yomogi517/Nucleo-F446RE_footer_ver1.0/README.md

## 使用時の注意
BNO055のフットプリントが電源とI2Cのピン側はあっていますが、INT,RESET,Voutなどのピン配が異なります。

基板外側のピンソケットのみ接続してください。
