yomogi517/Nucleo-F446RE_footer_ver1.0/回路図PDF.pdf

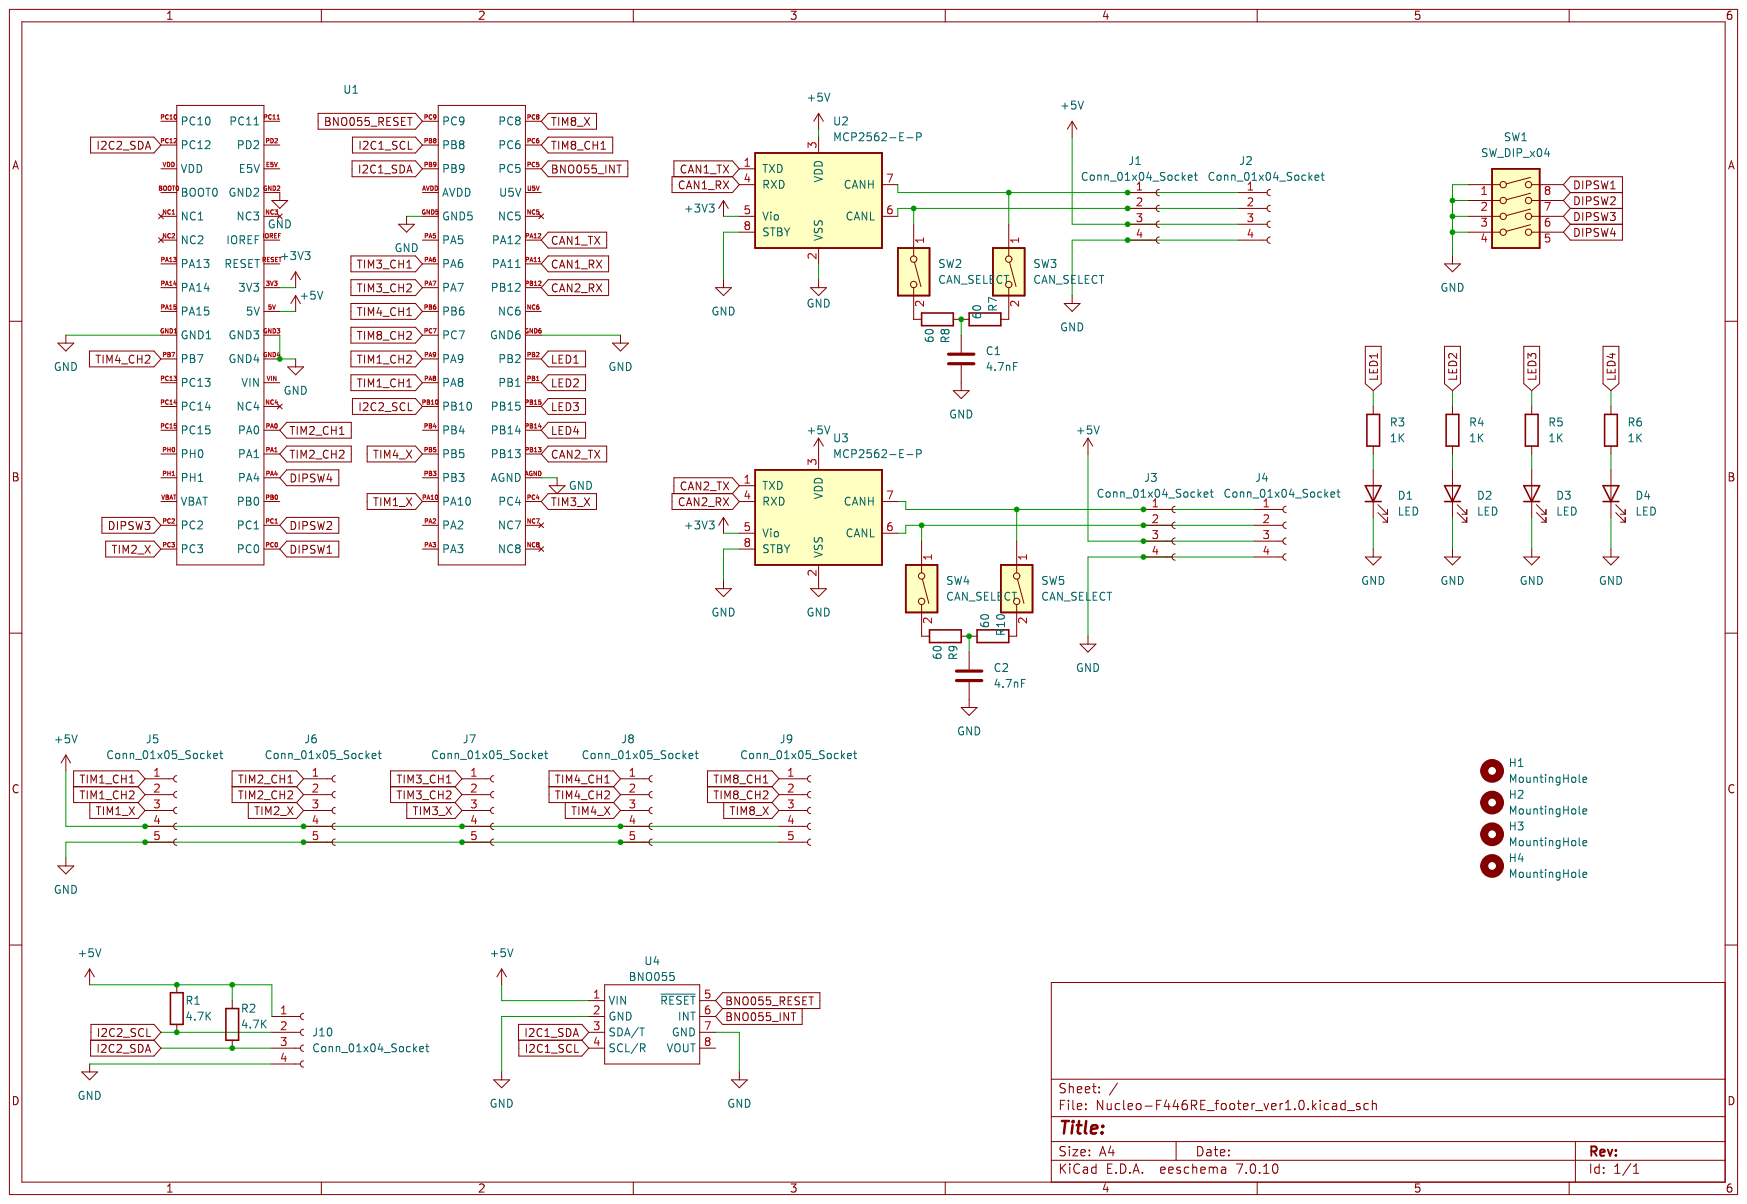
[picture p1: page 1]
