yomogi517/Nucleo-F446RE_footer_ver1.0/Nucleo-F446RE_footer_ver1.0.kicad_pcb

## KiCad design Nucleo-F446RE_footer_ver1.0.kicad_pcb (2024-04-28)

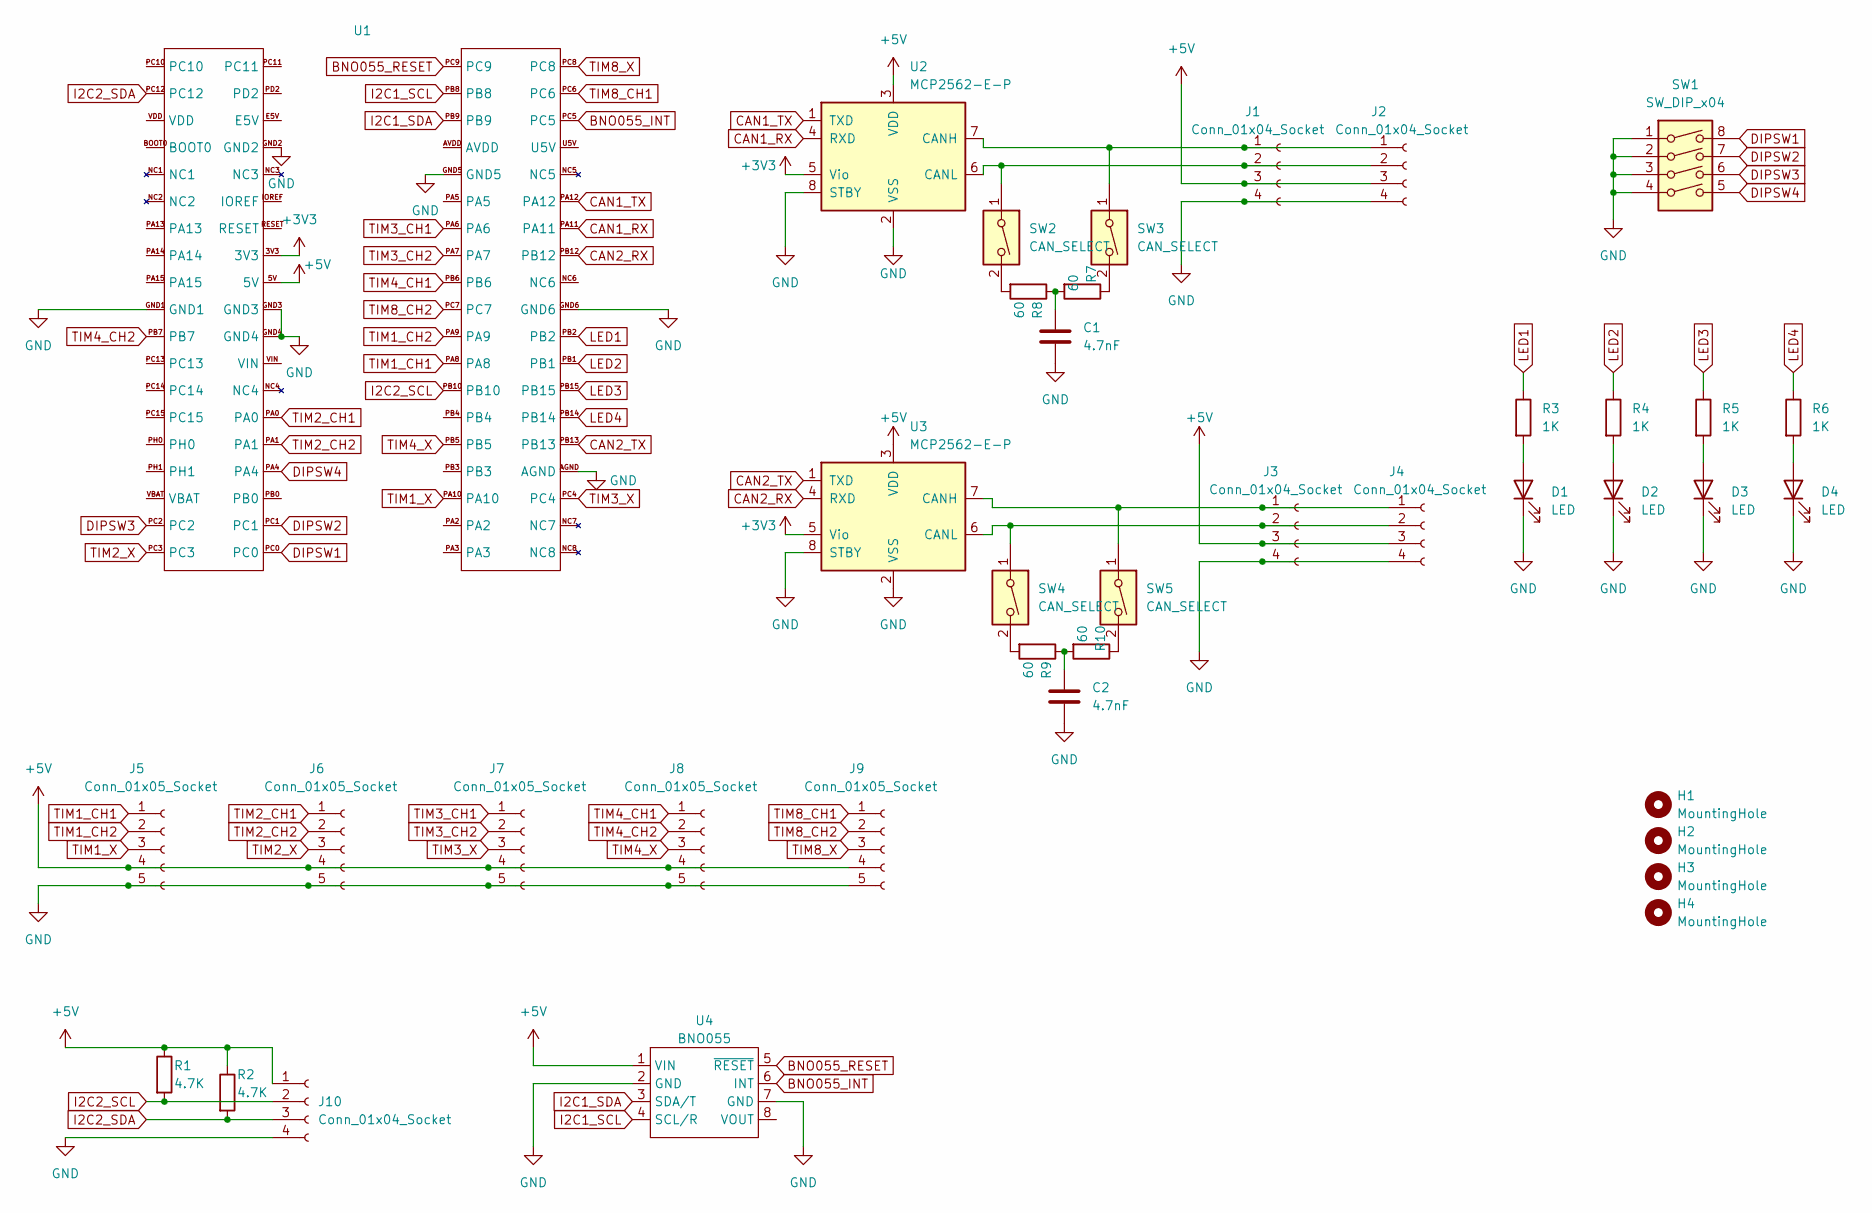
[picture p2: schematic Nucleo-F446RE_footer_ver1.0.kicad_sch]

Parts:
C1, C2: 4.7nF; C_Disc_D4.3mm_W1.9mm_P5.00mm
D1, D2, D3, D4: LED; LED_D3.0mm
H1, H2, H3, H4: MountingHole; MountingHole_3.2mm_M3
J1, J2, J3, J4: Conn_01x04_Socket; JST_XA_S04B-XASK-1_1x04_P2.50mm_Horizontal
J5, J6, J7, J8, J9: Conn_01x05_Socket; JST_XA_B05B-XASK-1_1x05_P2.50mm_Vertical
J10: Conn_01x04_Socket; JST_XA_B04B-XASK-1_1x04_P2.50mm_Vertical
R1, R2: 4.7K; R_Axial_DIN0207_L6.3mm_D2.5mm_P7.62mm_Horizontal
R3, R4, R5, R6: 1K; R_Axial_DIN0207_L6.3mm_D2.5mm_P7.62mm_Horizontal
R7, R8, R9, R10: 60; R_Axial_DIN0204_L3.6mm_D1.6mm_P7.62mm_Horizontal
SW1: SW_DIP_x04; DIP-8_W7.62mm
SW2, SW3, SW4, SW5: CAN_SELECT; PinHeader_1x02_P2.54mm_Vertical
U1: Nucleo64
U2, U3: MCP2562-E-P; DIP-8_W7.62mm
U4: BNO055; BNO055_akituki

Connections:
+3V3: U1.3V3, U2.5 (Vio), U3.5 (Vio)
+5V: J1.3, J2.3, J3.3, J4.3, J5.4, J6.4, J7.4, J8.4, J9.4, J10.1, R1.1, R2.1, U1.5V, U2.3 (VDD), U3.3 (VDD), U4.1 (VIN)
BNO055_INT: U1.PC5, U4.6 (INT)
BNO055_RESET: U1.PC9, U4.5 (~RESET)
CAN1_RX: U1.PA11, U2.4 (RXD)
CAN1_TX: U1.PA12, U2.1 (TXD)
CAN2_RX: U1.PB12, U3.4 (RXD)
CAN2_TX: U1.PB13, U3.1 (TXD)
DIPSW1: SW1.8, U1.PC0
DIPSW2: SW1.7, U1.PC1
DIPSW3: SW1.6, U1.PC2
DIPSW4: SW1.5, U1.PA4
GND: C1.2, C2.2, D1.1 (K), D2.1 (K), D3.1 (K), D4.1 (K), J1.4, J2.4, J3.4, J4.4, J5.5, J6.5, J7.5, J8.5, J9.5, J10.4, SW1.1, SW1.2, SW1.3, SW1.4, U1.AGND, U1.GND1, U1.GND2, U1.GND3, U1.GND4, U1.GND5, U1.GND6, U2.2 (VSS), U2.8 (STBY), U3.2 (VSS), U3.8 (STBY), U4.2 (GND), U4.7 (GND)
I2C1_SCL: U1.PB8, U4.4 (SCL/R)
I2C1_SDA: U1.PB9, U4.3 (SDA/T)
I2C2_SCL: J10.2, R1.2, U1.PB10
I2C2_SDA: J10.3, R2.2, U1.PC12
LED1: R3.1, U1.PB2
LED2: R4.1, U1.PB1
LED3: R5.1, U1.PB15
LED4: R6.1, U1.PB14
unnamed: C1.1, R7.2, R8.1
unnamed: C2.1, R9.1, R10.2
unnamed: D1.2 (A), R3.2
unnamed: D2.2 (A), R4.2
unnamed: D3.2 (A), R5.2
unnamed: D4.2 (A), R6.2
unnamed: J1.1, J2.1, SW3.1, U2.7 (CANH)
unnamed: J1.2, J2.2, SW2.1, U2.6 (CANL)
unnamed: J3.1, J4.1, SW5.1, U3.7 (CANH)
unnamed: J3.2, J4.2, SW4.1, U3.6 (CANL)
unnamed: R7.1, SW3.2
unnamed: R8.2, SW2.2
unnamed: R9.2, SW4.2
unnamed: R10.1, SW5.2
TIM1_CH1: J5.1, U1.PA8
TIM1_CH2: J5.2, U1.PA9
TIM1_X: J5.3, U1.PA10
TIM2_CH1: J6.1, U1.PA0
TIM2_CH2: J6.2, U1.PA1
TIM2_X: J6.3, U1.PC3
TIM3_CH1: J7.1, U1.PA6
TIM3_CH2: J7.2, U1.PA7
TIM3_X: J7.3, U1.PC4
TIM4_CH1: J8.1, U1.PB6
TIM4_CH2: J8.2, U1.PB7
TIM4_X: J8.3, U1.PB5
TIM8_CH1: J9.1, U1.PC6
TIM8_CH2: J9.2, U1.PC7
TIM8_X: J9.3, U1.PC8

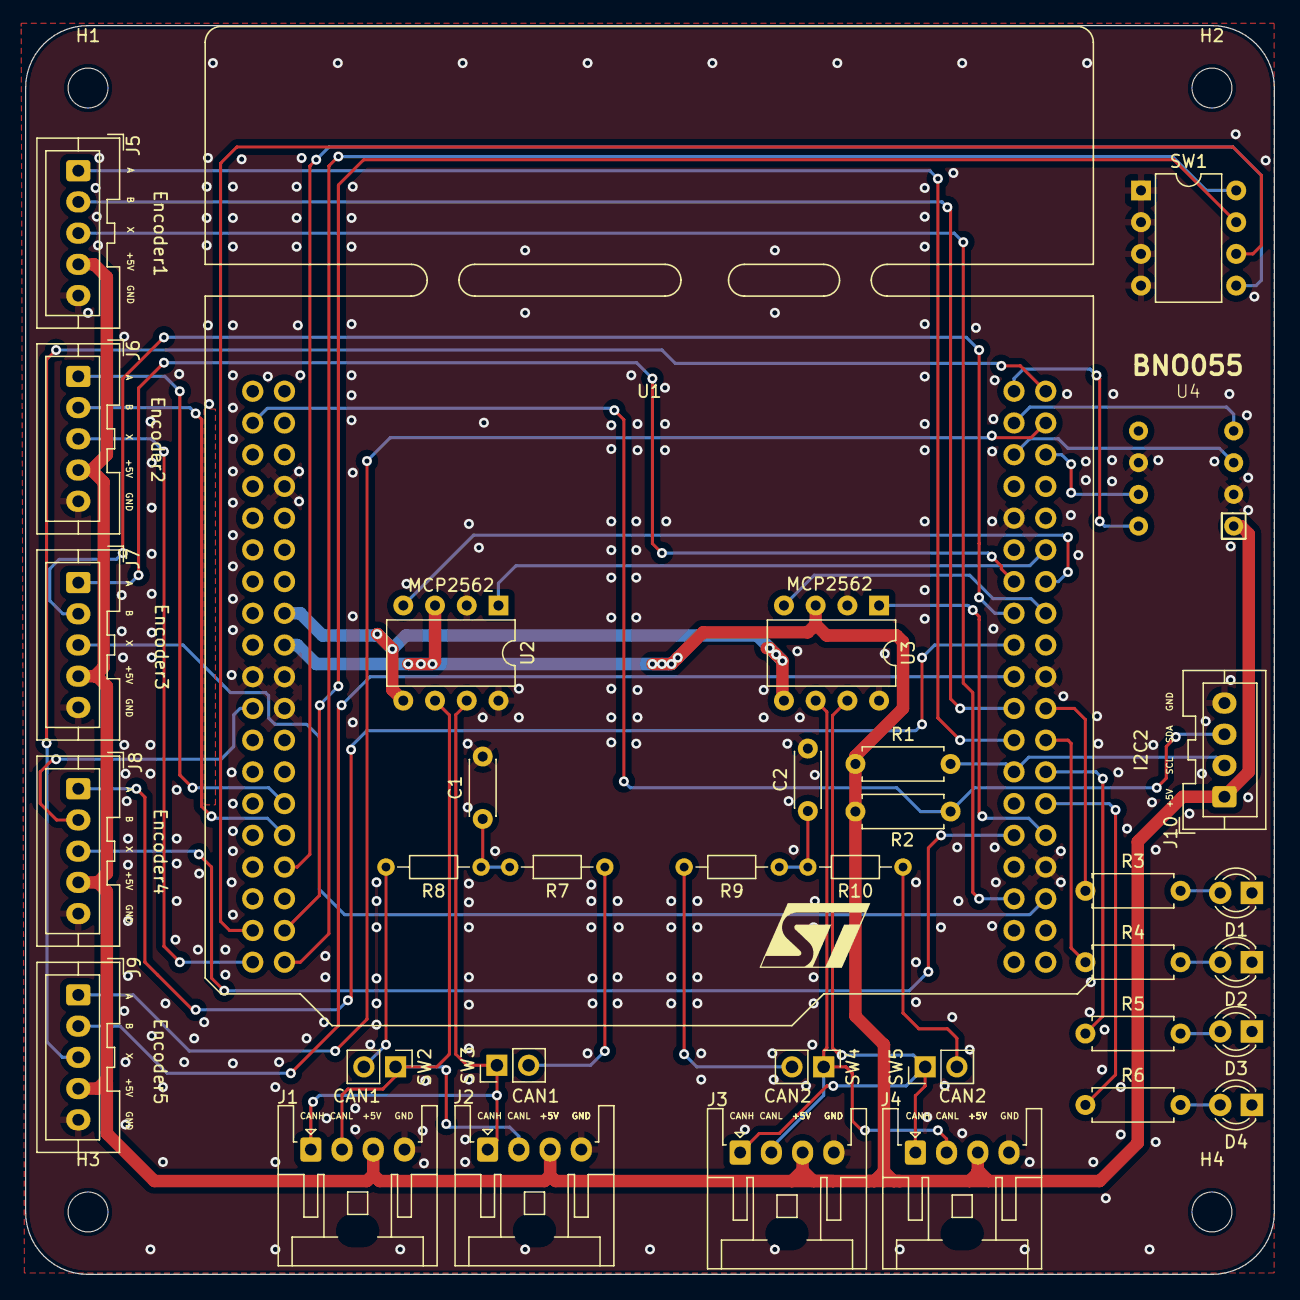
[picture p3: board Nucleo-F446RE_footer_ver1.0.kicad_pcb from above]

Board: 2 copper layers, 100.0 x 100.0 mm, 39 parts (0 on the bottom side), 50 nets.
